svadhij/Mup-Project-on-IC-Tester/(list of files, drawings)

Other design files:
ictesterdes.DSN
